Darexsh/IoT_Wetterstation/3D-Case/Frame.stl

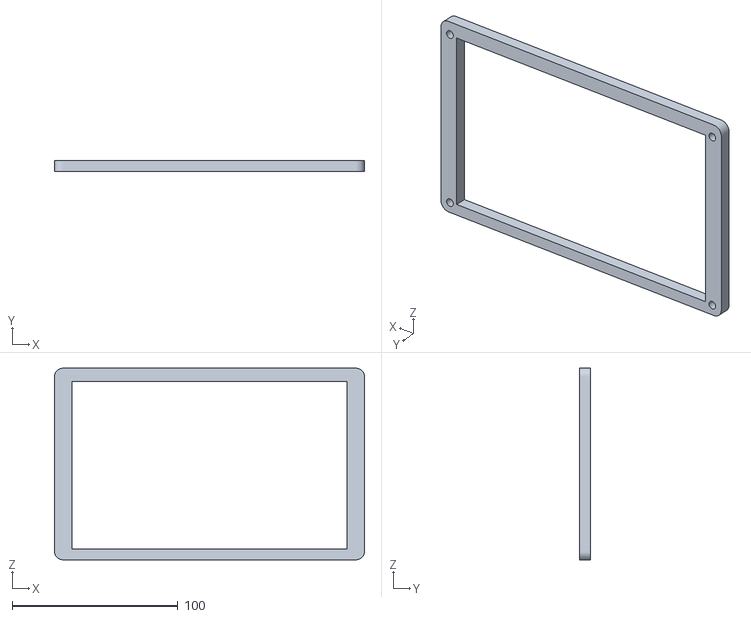
[picture p4: CAD file, 2025-10-27]
3D-Case/Frame.stl
187.0 x 6.56 x 115.6
