Darexsh/IoT_Wetterstation/3D-Case/Wetterstation.3mf

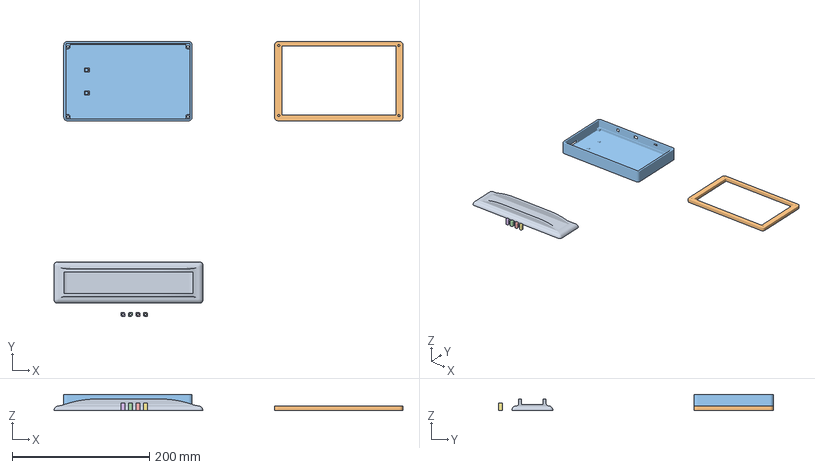
[picture p5: CAD file, 2025-10-22]
3D-Case/Wetterstation.3mf
508.4 x 400.6 x 23.7 mm
Stand.stl
Frame.stl
Case.stl
Spacer1.stl
Spacer2.stl
Spacer3.stl
Spacer4.stl
