Darexsh/IoT_Wetterstation/Hardware/Lib-3D-Files/SSD1963.step

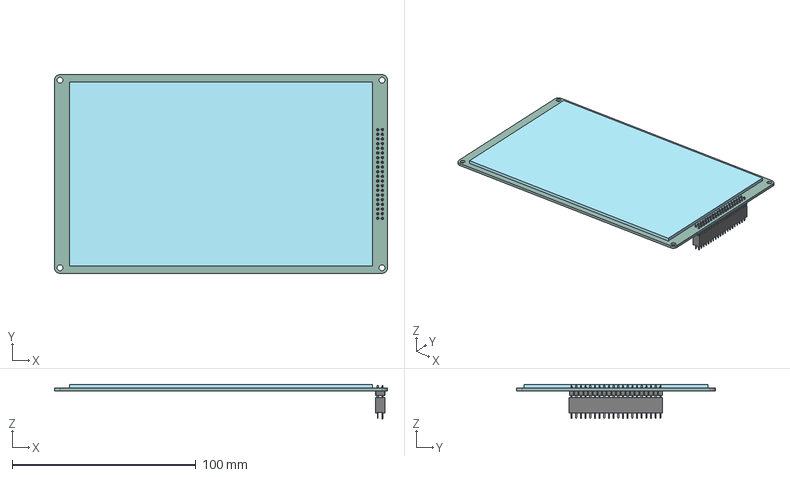
[picture p6: CAD file, 2025-09-12]
Hardware/Lib-3D-Files/SSD1963.step
181.0 x 108.0 x 18.7 mm
PinHeader_2x20_P254mm_Vertical
PinSocket_2x20_P2.54mm_Vertical
