Darexsh/IoT_Wetterstation/3D-Case/Spacer2.stl

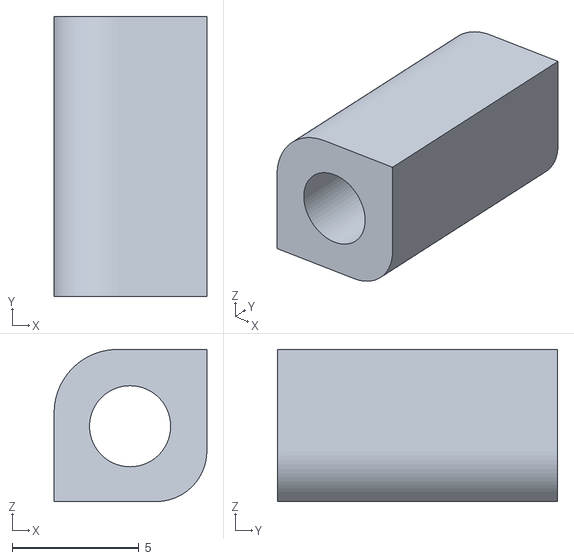
[picture p7: CAD file, 2025-10-21]
3D-Case/Spacer2.stl
6.03 x 11.1 x 6.00
