Darexsh/IoT_Wetterstation/Hardware/Lib-3D-Files/ESP32-S3-WROOM-1U-N8R8.stp

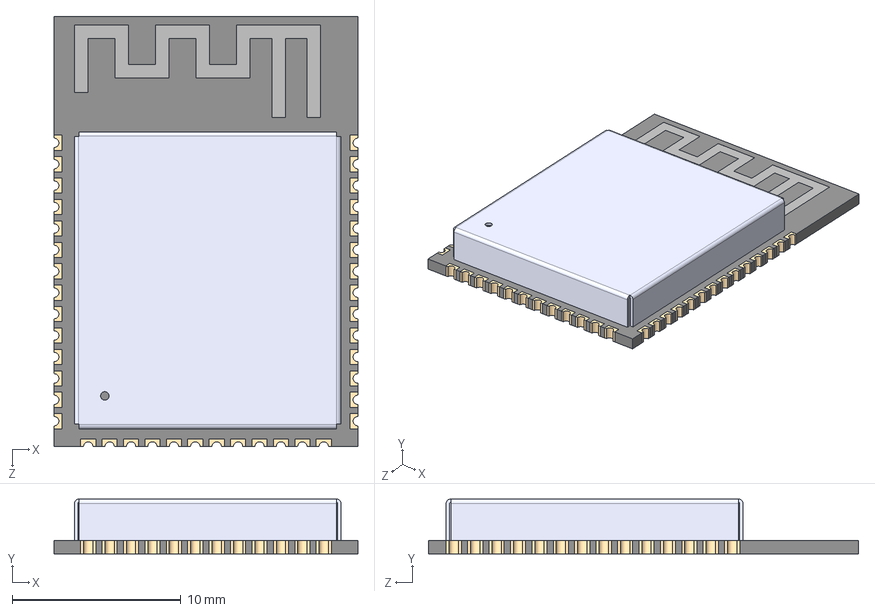
[picture p8: CAD file, 2025-09-12]
Hardware/Lib-3D-Files/ESP32-S3-WROOM-1U-N8R8.stp
18.0 x 3.25 x 25.5 mm
