Darexsh/IoT_Wetterstation/Hardware/Lib-3D-Files/KMR421NGLFS.step

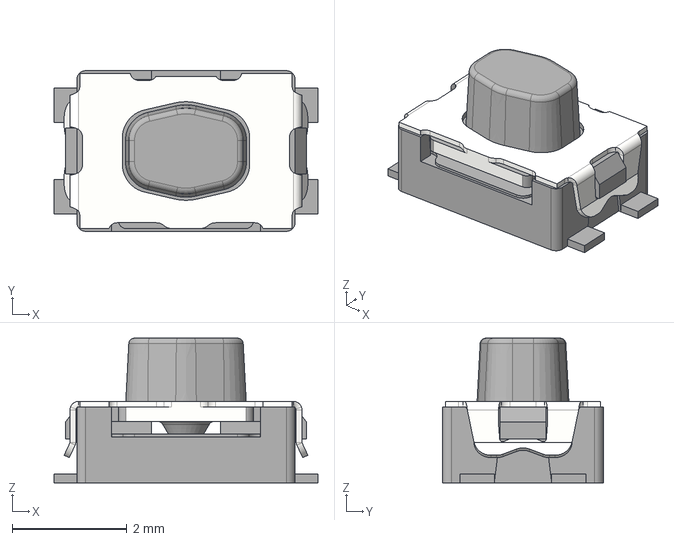
[picture p9: CAD file, 2025-09-12]
Hardware/Lib-3D-Files/KMR421NGLFS.step
4.60 x 2.80 x 2.52 mm
