Darexsh/IoT_Wetterstation/Hardware/Lib-3D-Files/USB-C.stp

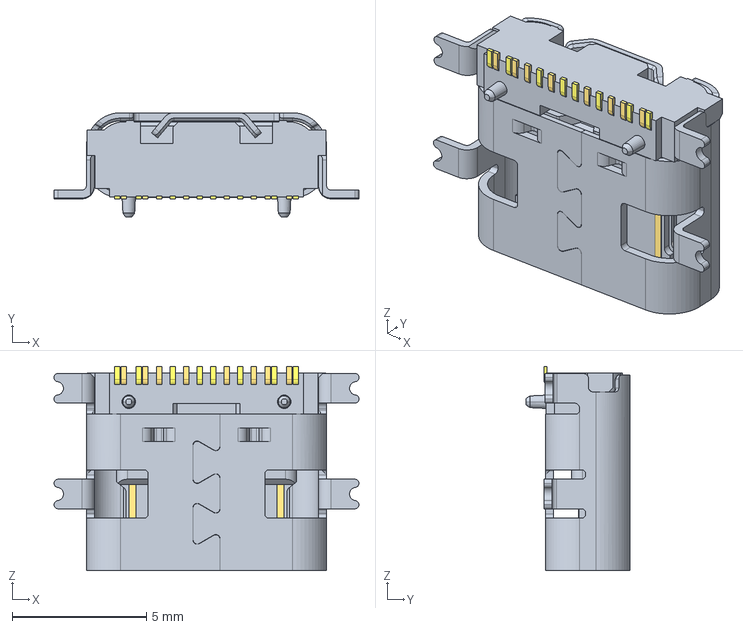
[picture p10: CAD file, 2025-09-12]
Hardware/Lib-3D-Files/USB-C.stp
11.3 x 3.89 x 7.60 mm
