Darexsh/IoT_Wetterstation/Hardware/Lib-3D-Files/JST-SH1.0-4P.stp

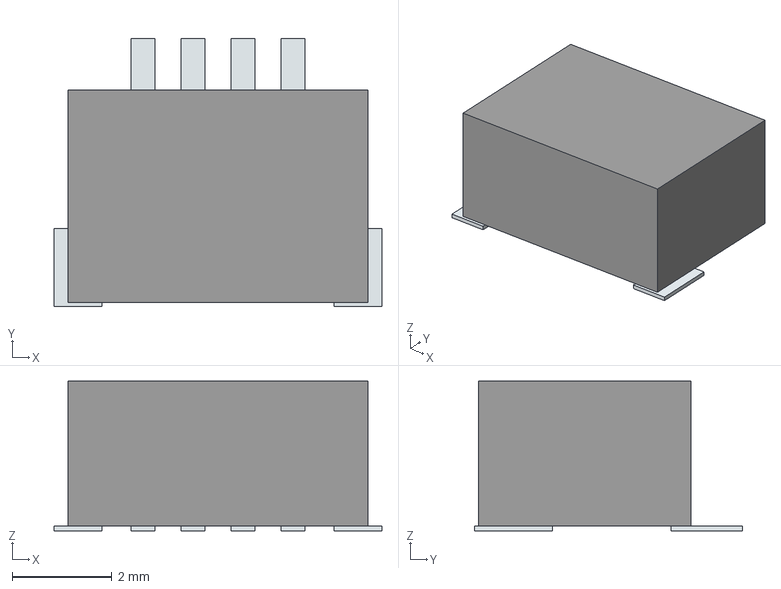
[picture p11: CAD file, 2025-09-12]
Hardware/Lib-3D-Files/JST-SH1.0-4P.stp
6.56 x 5.37 x 3.00 mm
Pins
