Darexsh/IoT_Wetterstation/3D-Case/Stand.stl

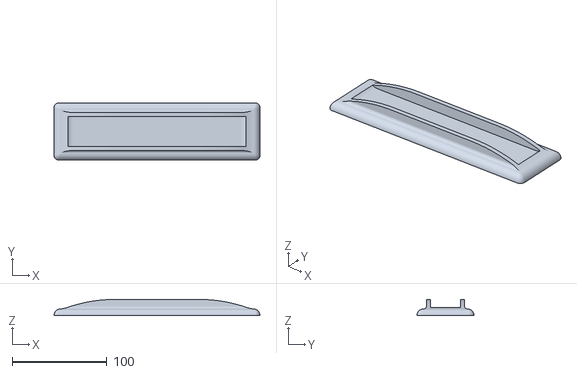
[picture p12: CAD file, 2025-10-21]
3D-Case/Stand.stl
217.0 x 60.2 x 17.0
