Darexsh/IoT_Wetterstation/Hardware/Lib-3D-Files/USB-C_PD.stp

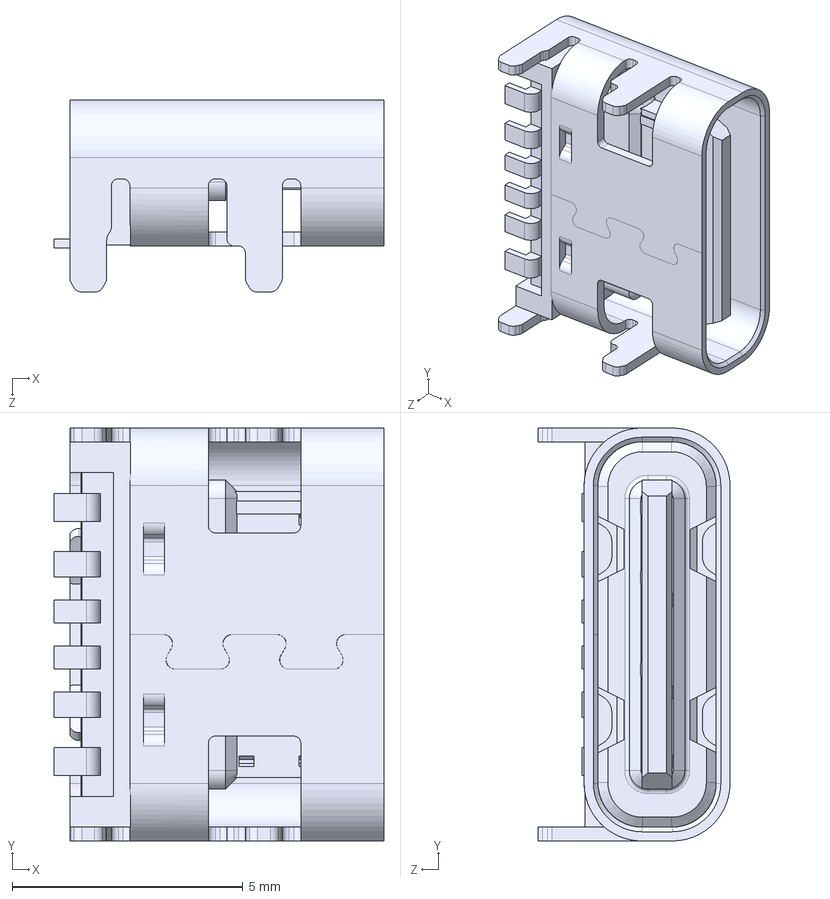
[picture p13: CAD file, 2025-09-12]
Hardware/Lib-3D-Files/USB-C_PD.stp
7.14 x 8.94 x 4.16 mm
