Darexsh/IoT_Wetterstation/3D-Case/Case.stl

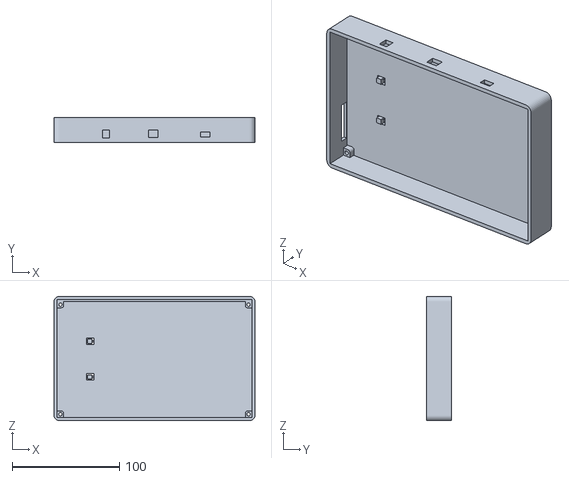
[picture p14: CAD file, 2025-10-21]
3D-Case/Case.stl
187.0 x 23.7 x 115.6
