Darexsh/IoT_Wetterstation/Hardware/Lib-3D-Files/VCNL4040M3OE.step

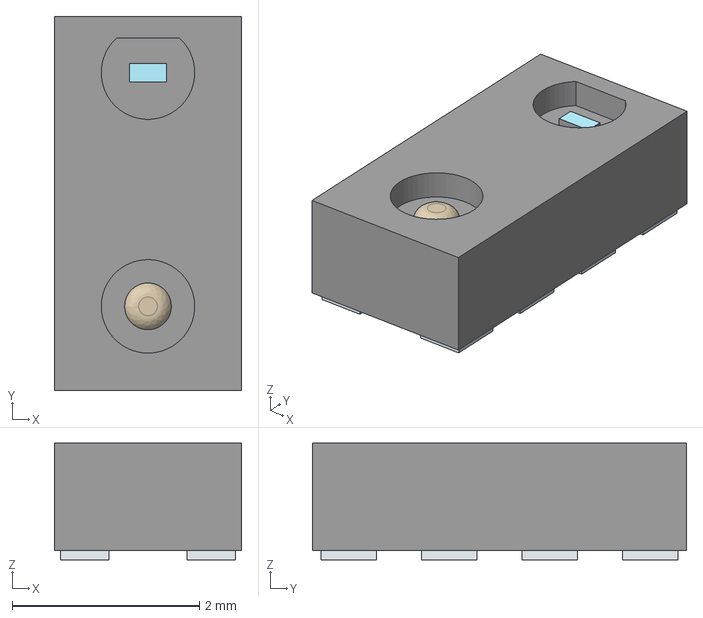
[picture p15: CAD file, 2025-09-12]
Hardware/Lib-3D-Files/VCNL4040M3OE.step
2.00 x 4.00 x 1.25 mm
Pins
