Darexsh/IoT_Wetterstation/Hardware/Lib-3D-Files/BME688.stp

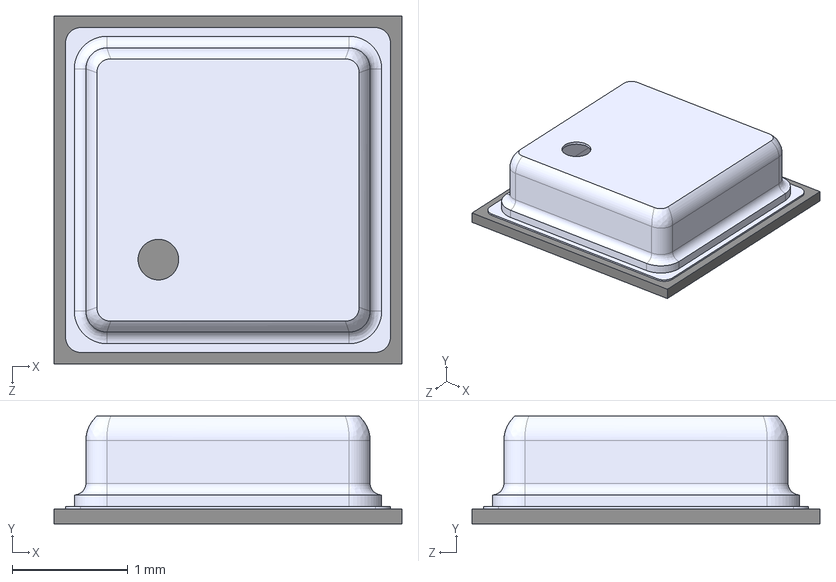
[picture p16: CAD file, 2025-09-12]
Hardware/Lib-3D-Files/BME688.stp
3.00 x 0.93 x 3.00 mm
