Darexsh/IoT_Wetterstation/(list of files, cad)

Other CAD files:
3D-Case/Spacer3.stl
3D-Case/Spacer4.stl
3D-Case/Spacer1.stl
