Darexsh/IoT_Wetterstation/Docs/iot_weatherstation_full_vcut_schematics.pdf

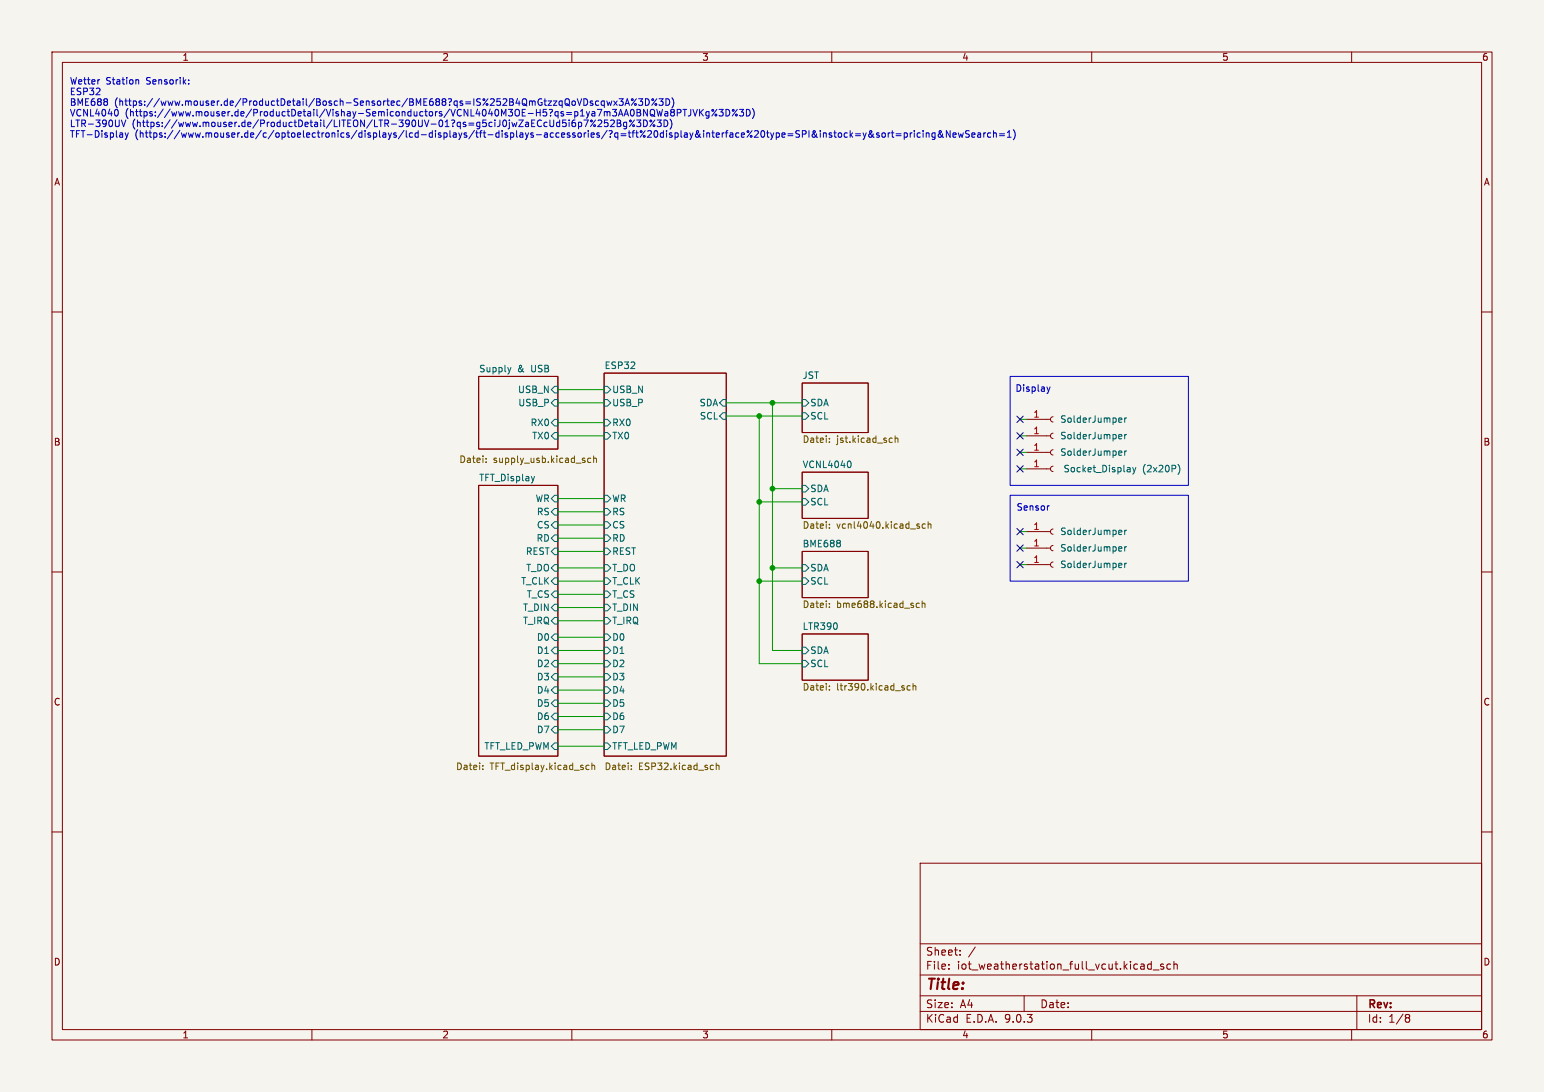
[picture p17: page 1]

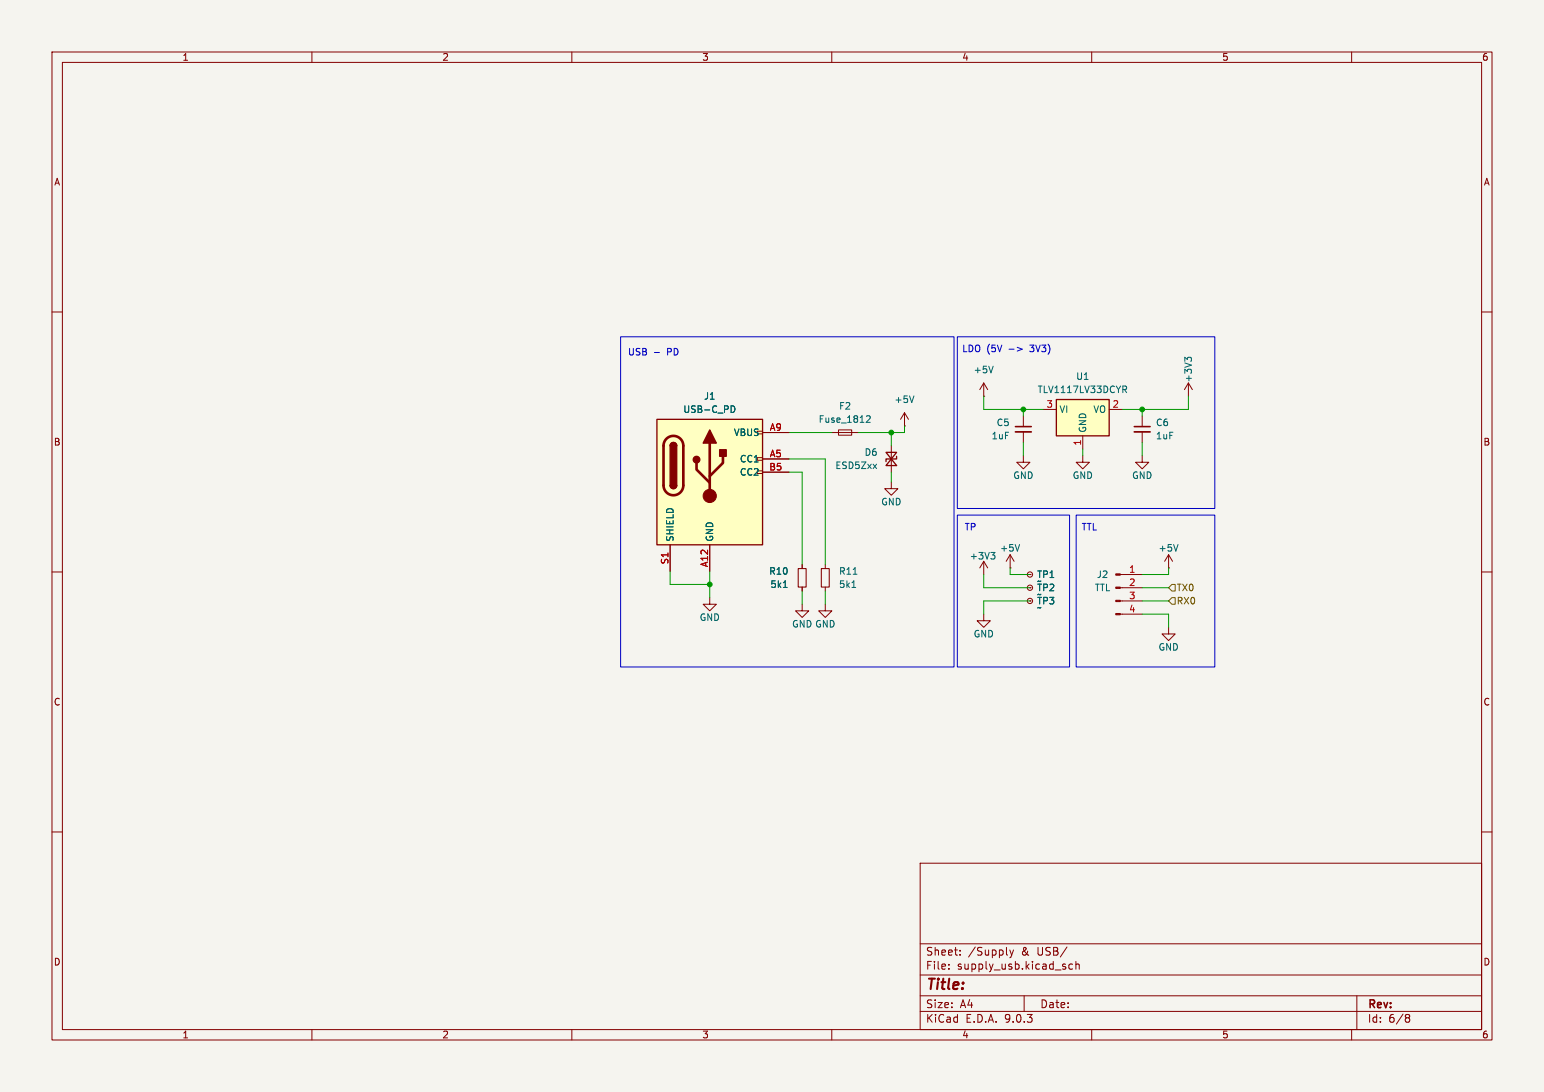
[picture p18: page 2]

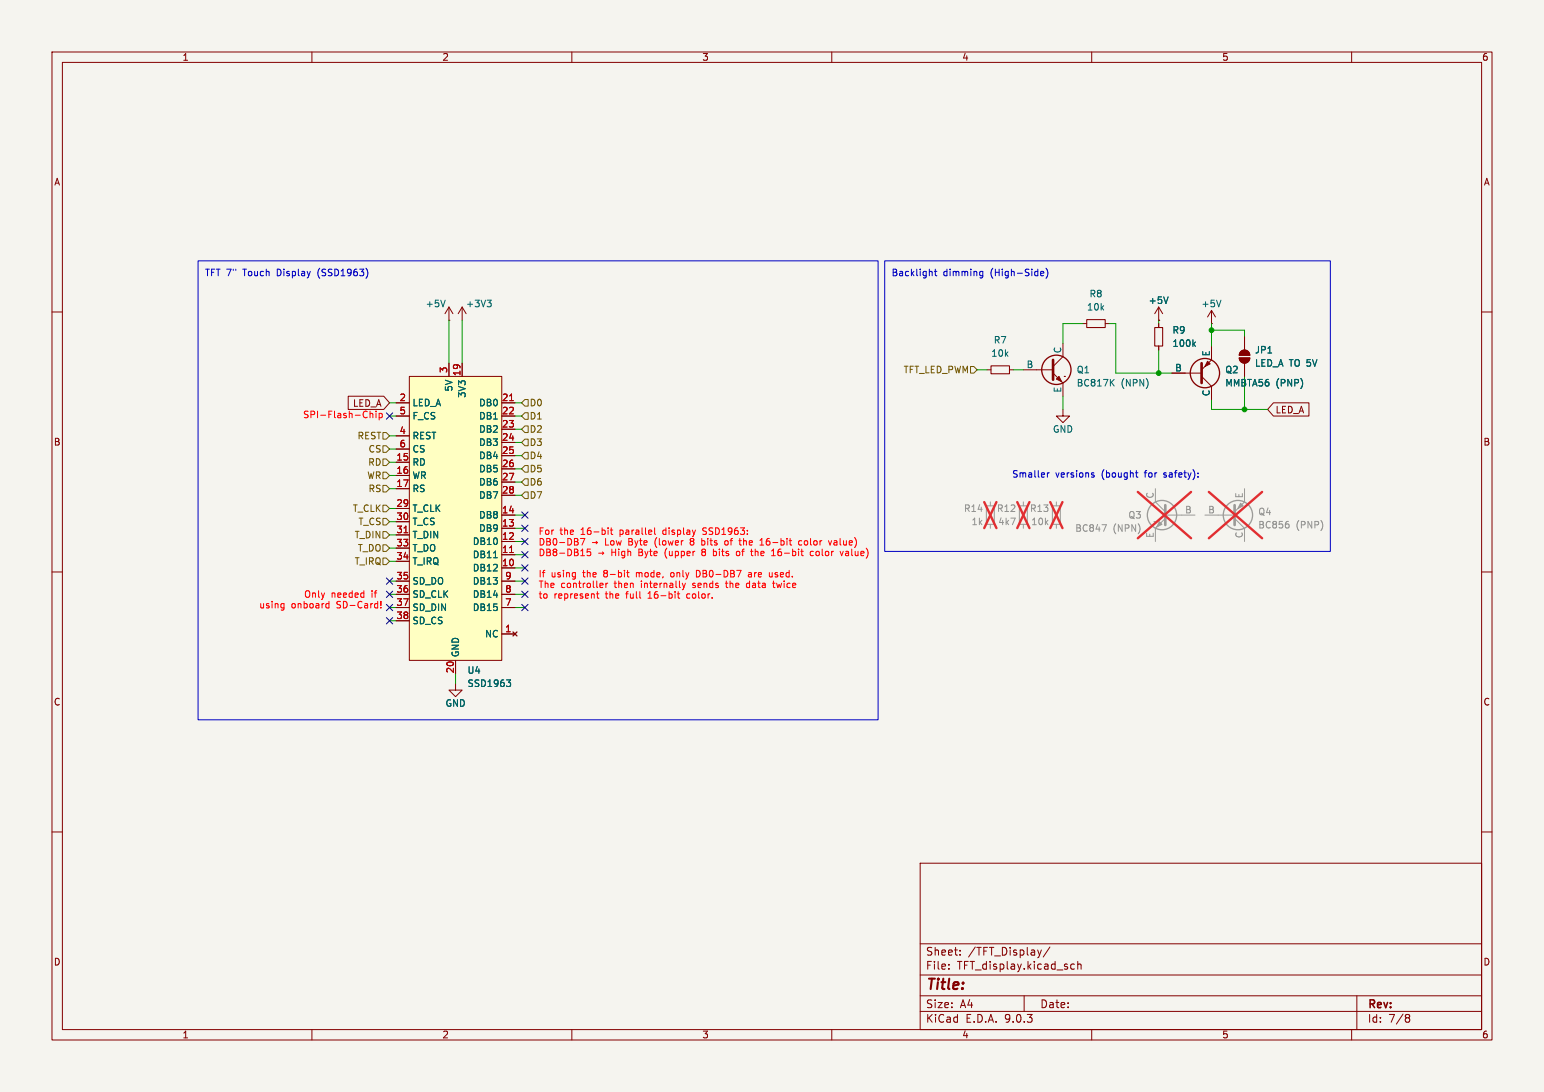
[picture p19: page 3]

Id: 7/8 Title: File: TFT_display.kicad_sch Sheet: /TFT_Display/ R14

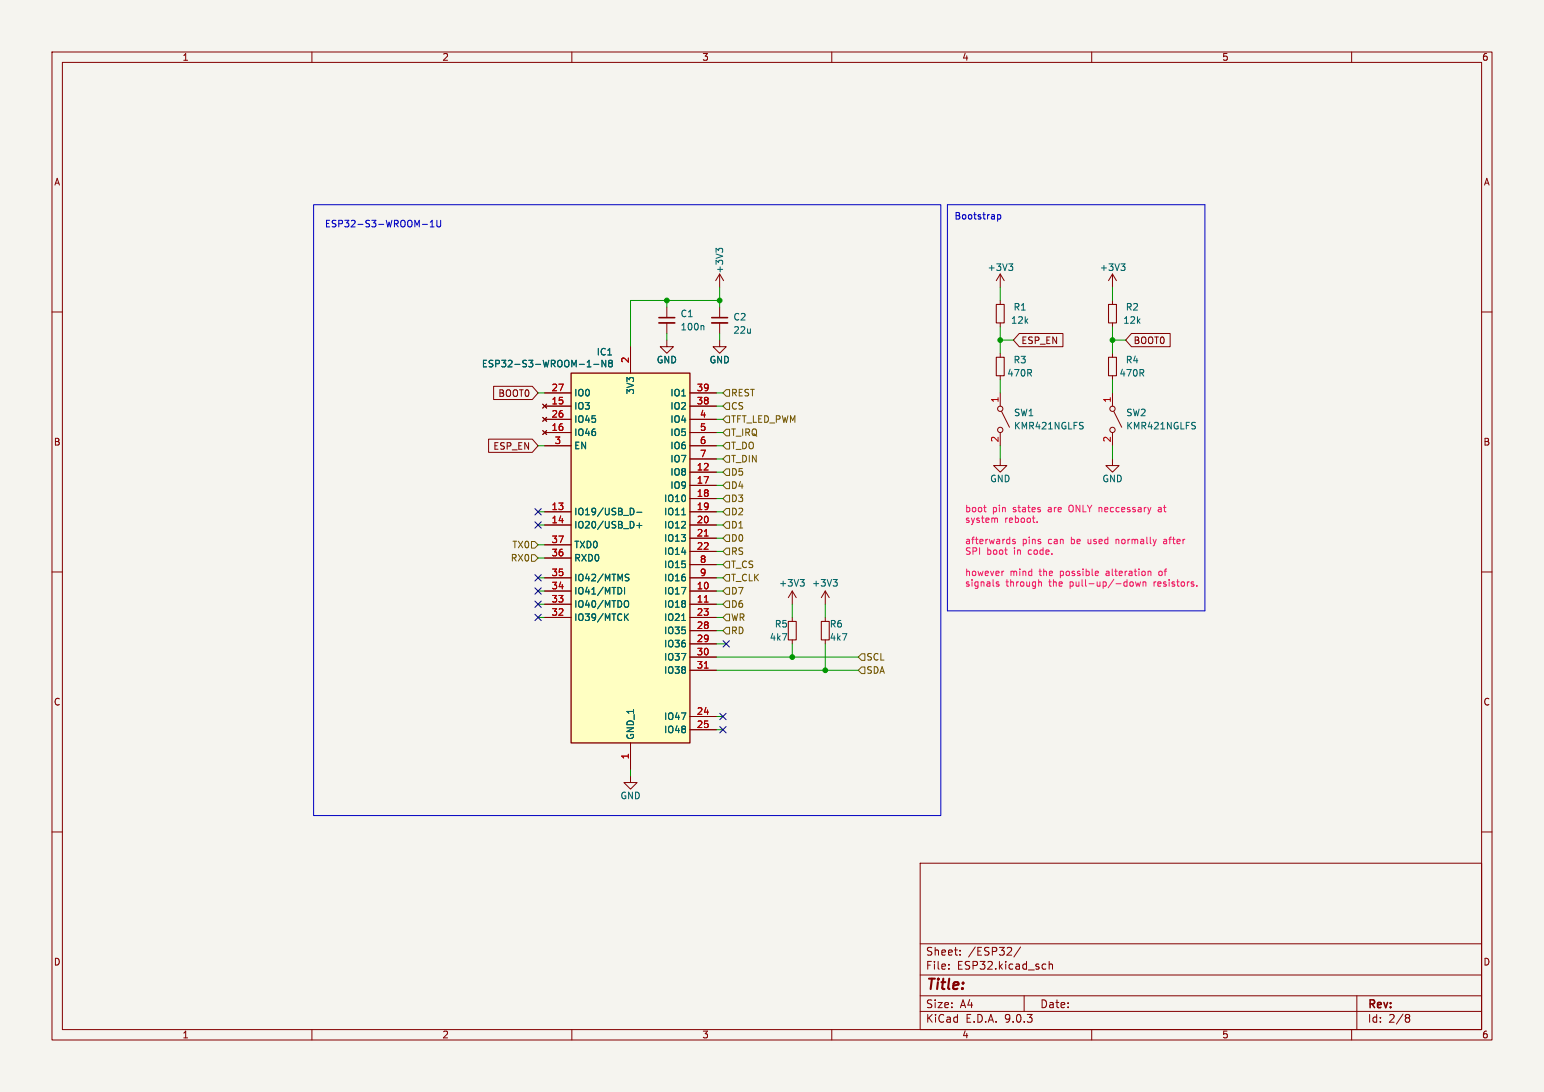
[picture p20: page 4]

Id: 2/8 Title: File: ESP32.kicad_sch Sheet: /ESP32/

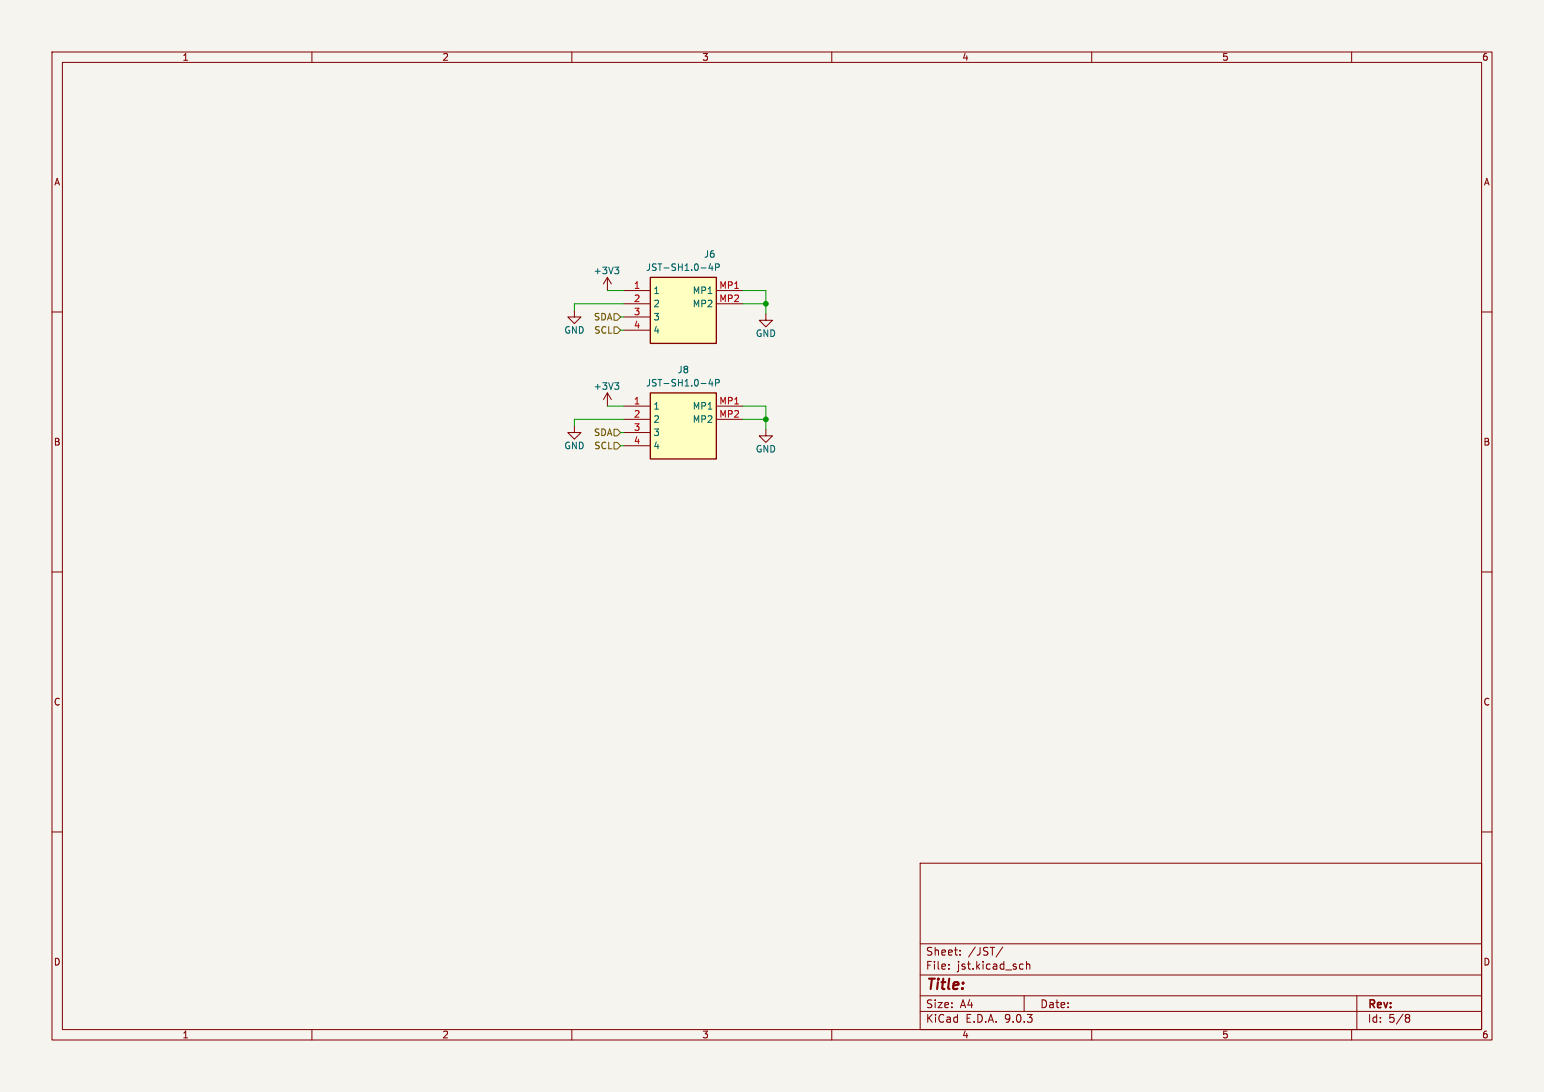
[picture p21: page 5]

Id: 5/8 Title: File: jst.kicad_sch Sheet: /JST/

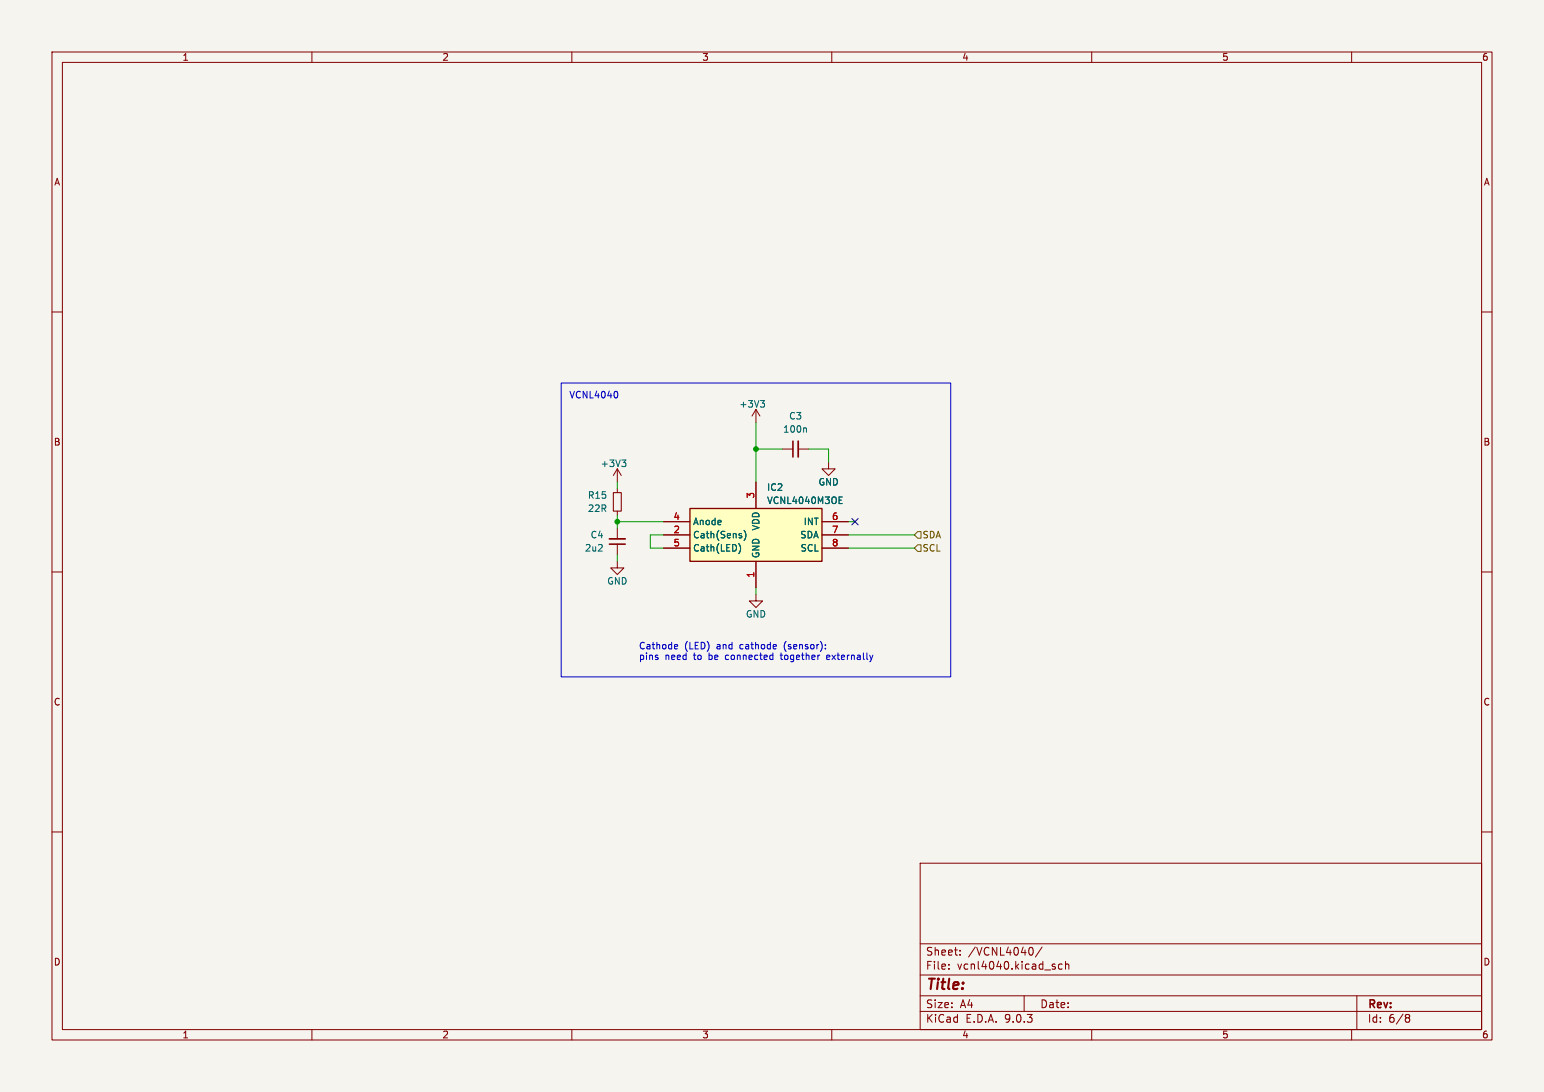
[picture p22: page 6]

Id: 6/8 Title: File: vcnl4040.kicad_sch Sheet: /VCNL4040/ GND

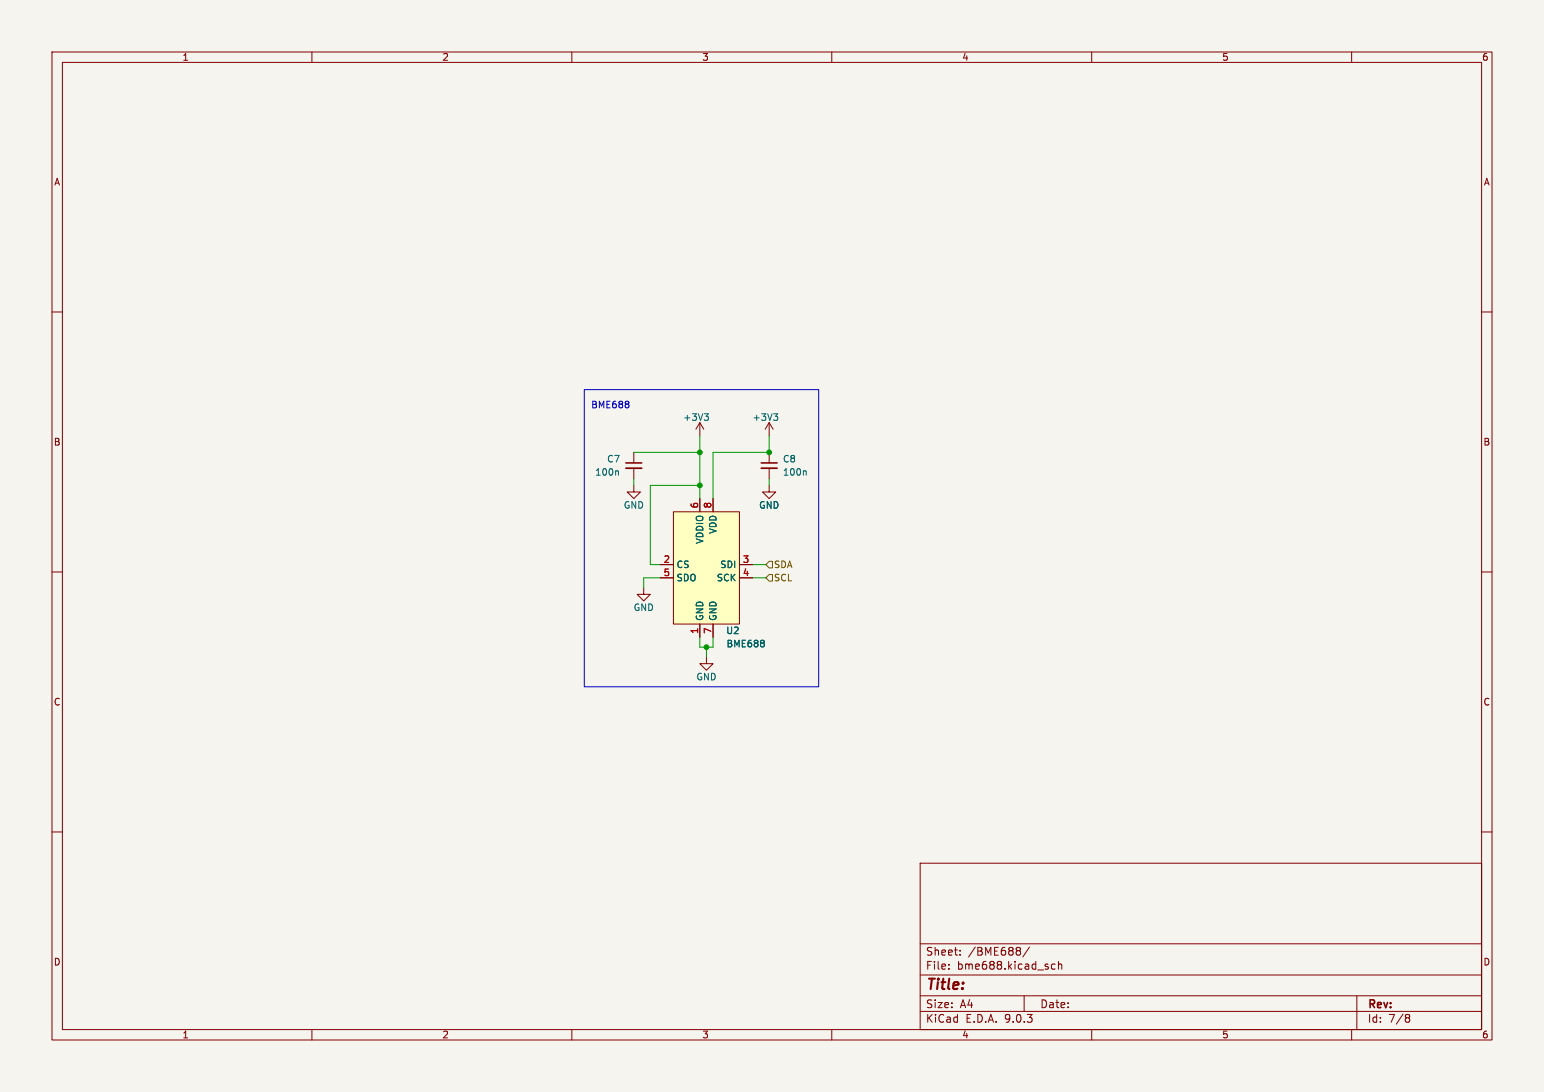
[picture p23: page 7]

Id: 7/8 Title: File: bme688.kicad_sch Sheet: /BME688/ GND

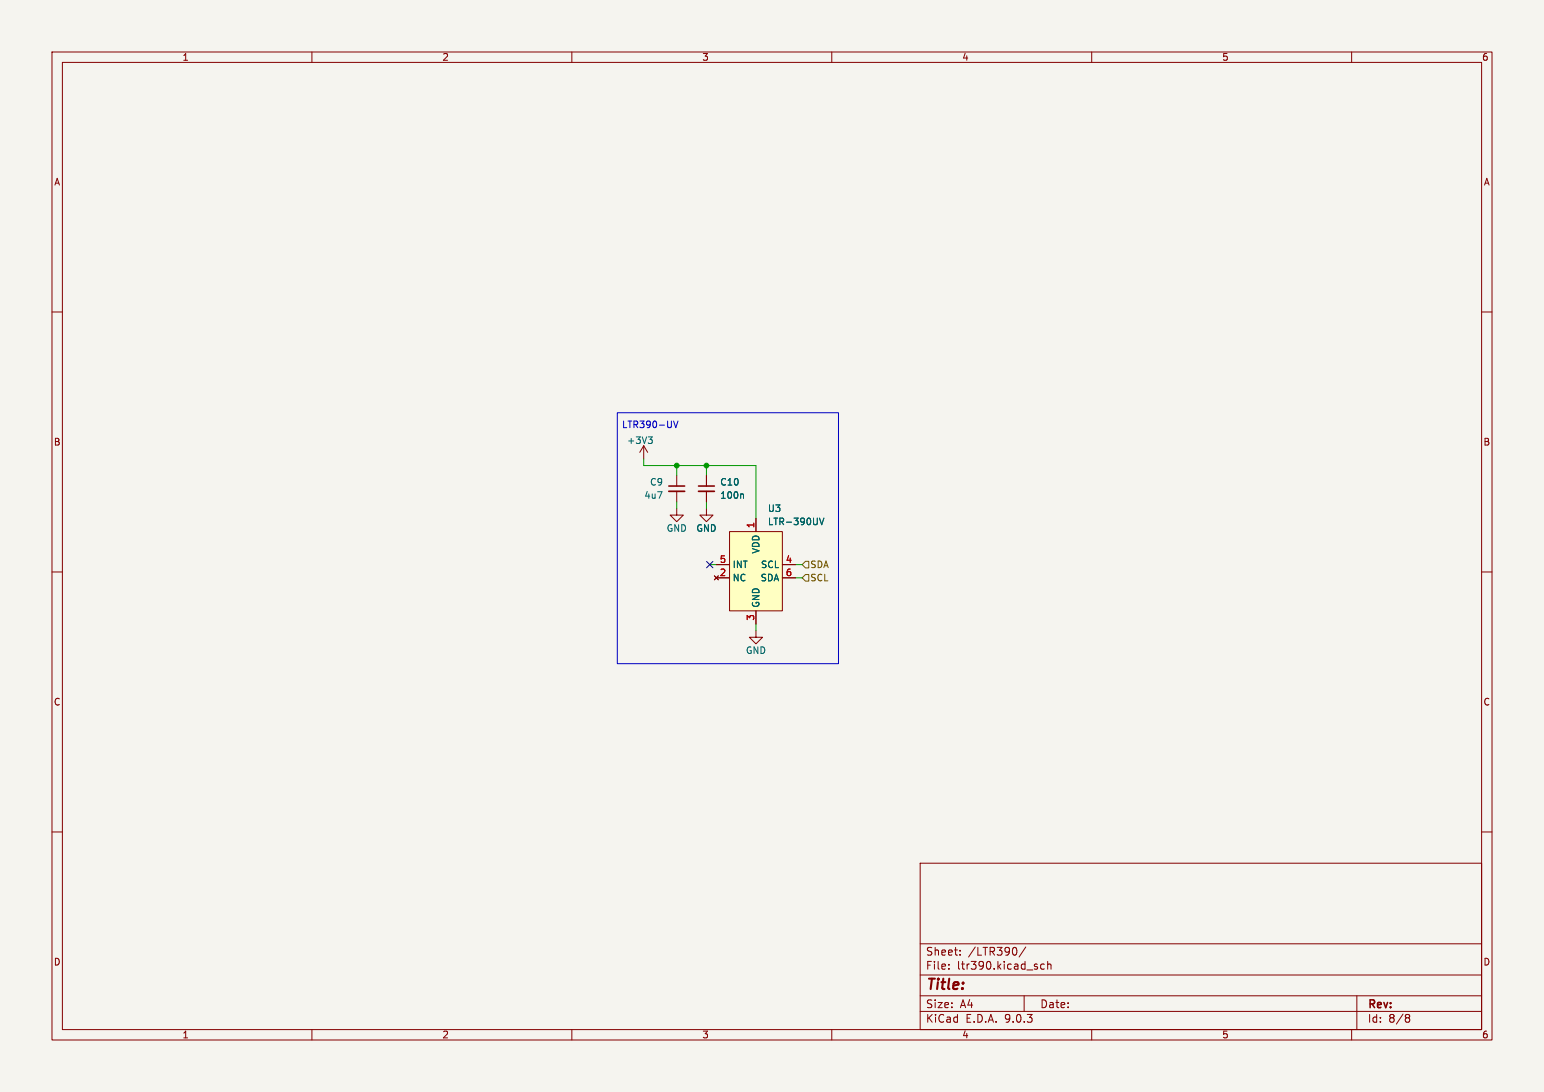
[picture p24: page 8]

Id: 8/8 Title: File: ltr390.kicad_sch Sheet: /LTR390/
