Darexsh/IoT_Wetterstation/Docs/iot_weatherstation_full_vcut_board_layers.pdf

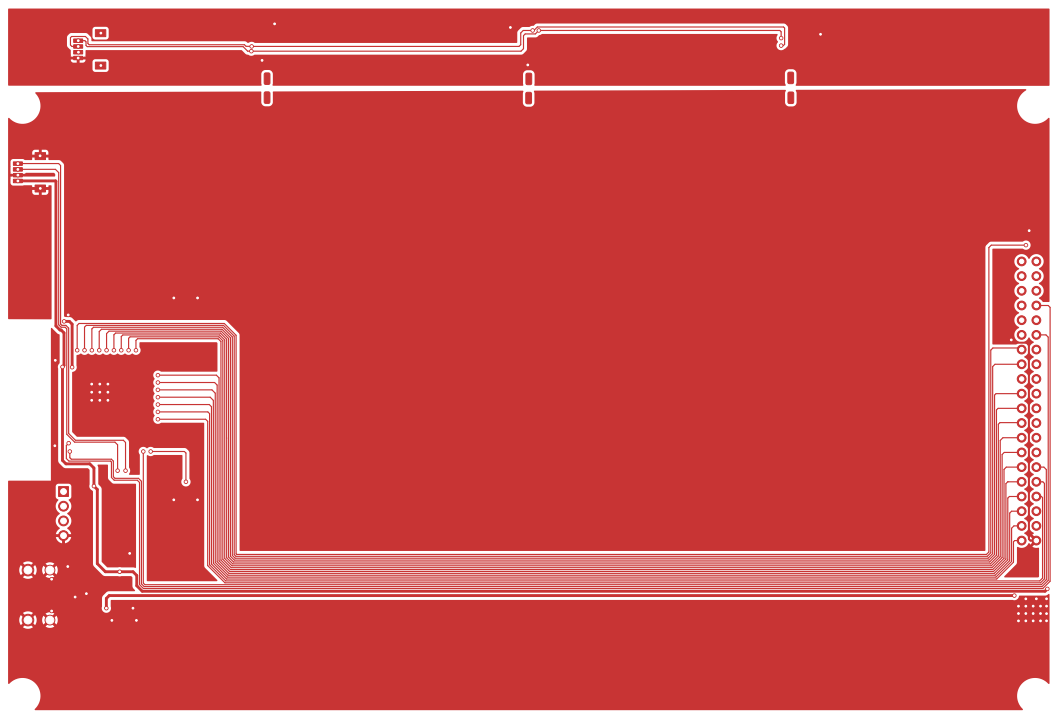
[picture p25: page 1]

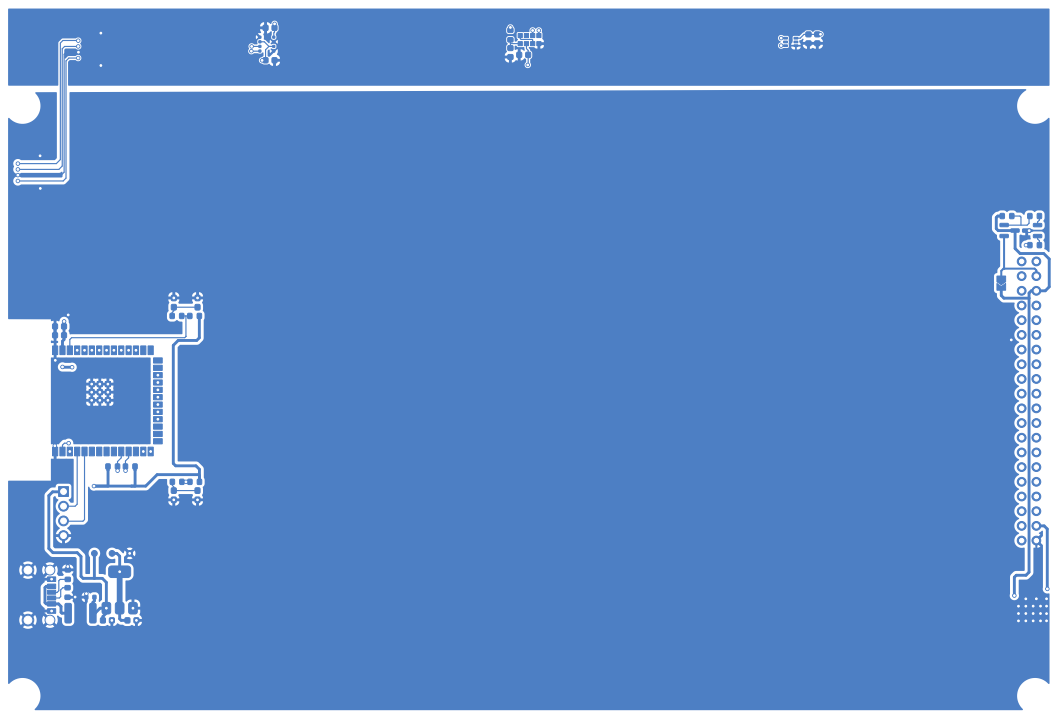
[picture p26: page 2]

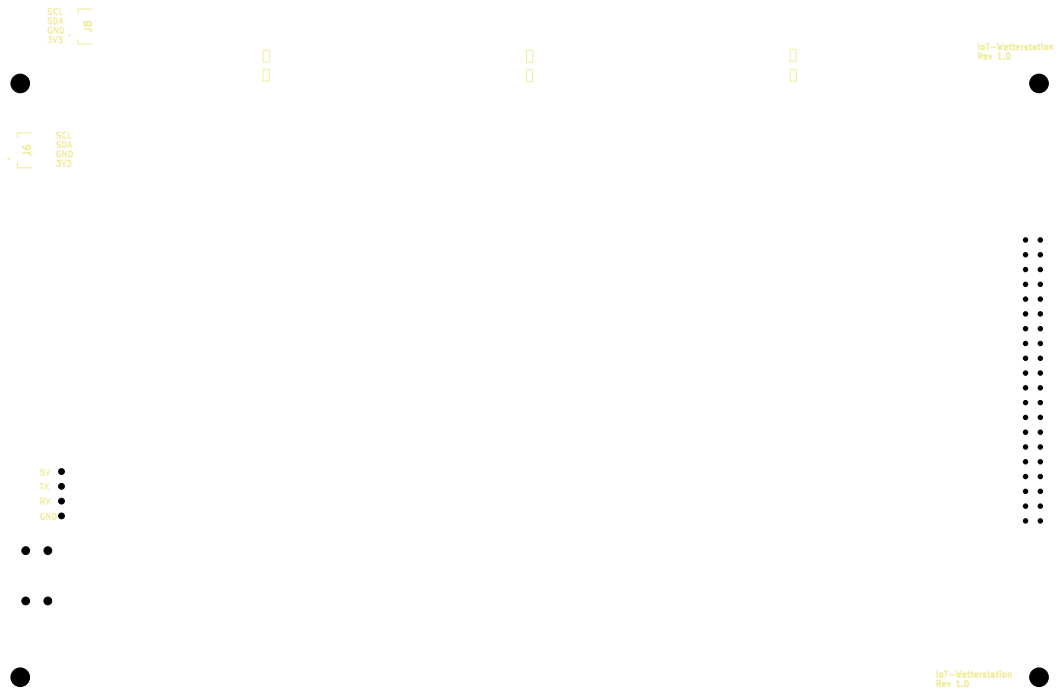
[picture p27: page 3]
5VGND

SCL SDA GND

IoT-Wetterstation Rev 1.0 RX

IoT-Wetterstation Rev 1.0

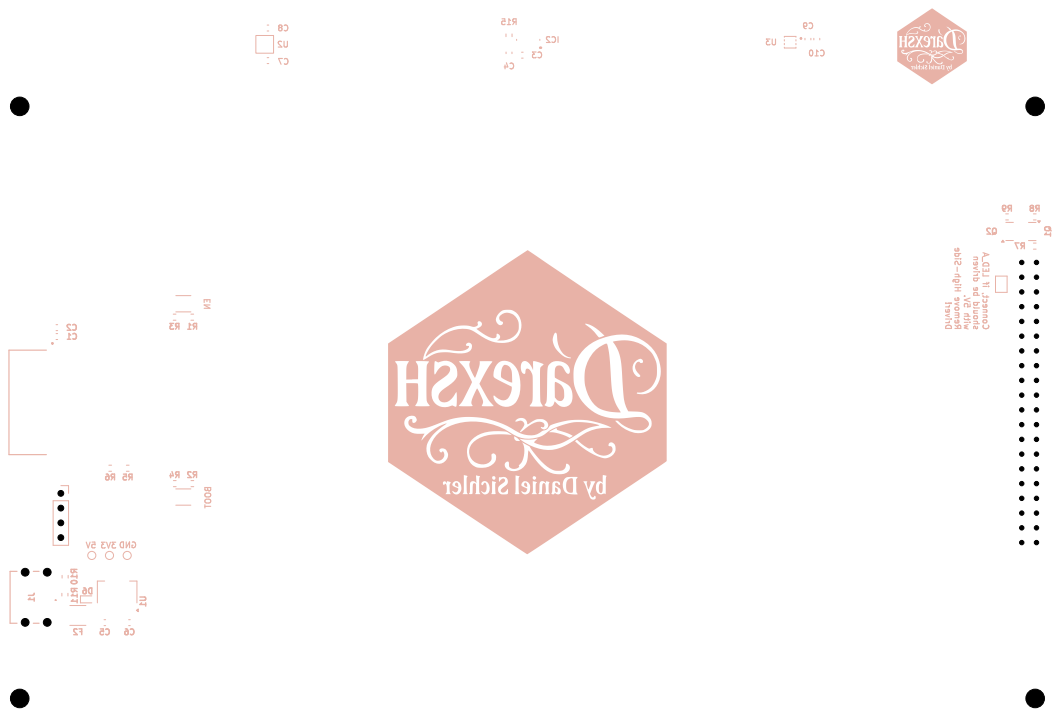
[picture p28: page 4]

5V EN BOOT Connect, if LED_A should be driven with 5V. Remove High-Side Driver!

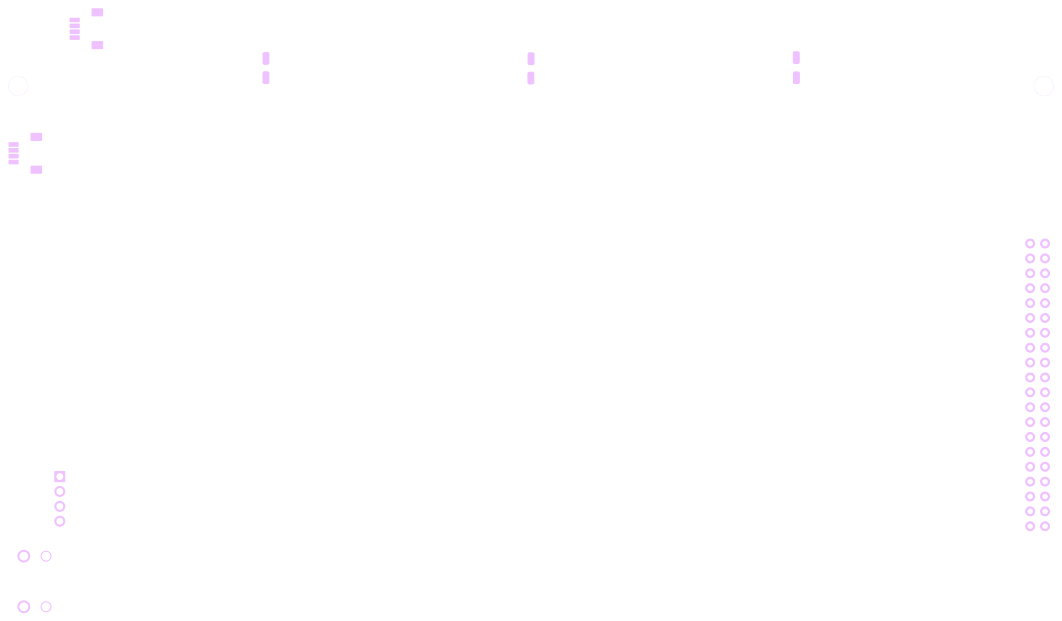
[picture p29: page 5]

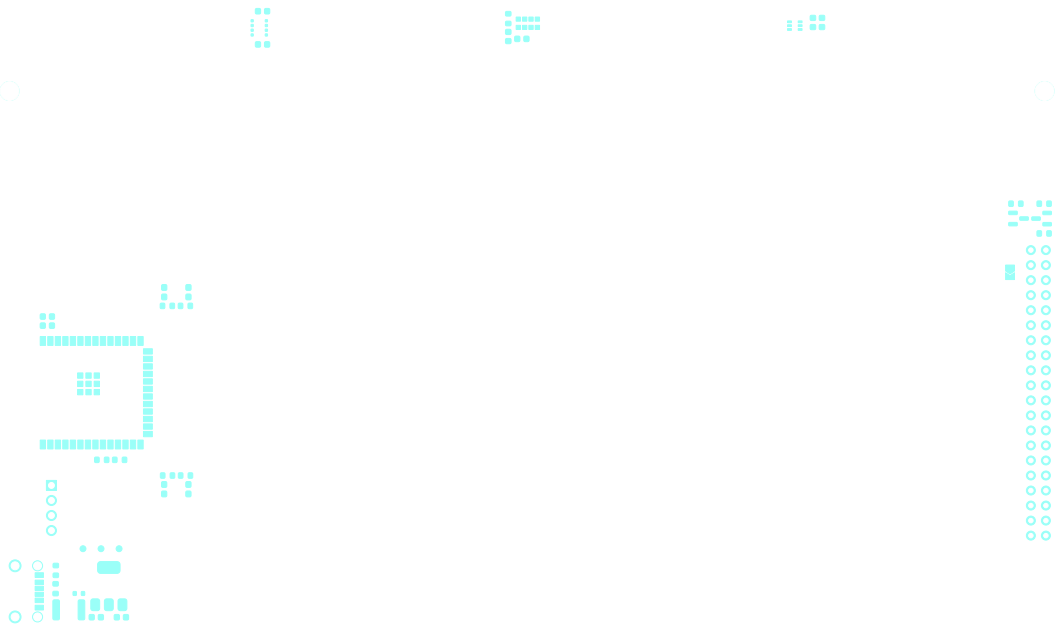
[picture p30: page 6]

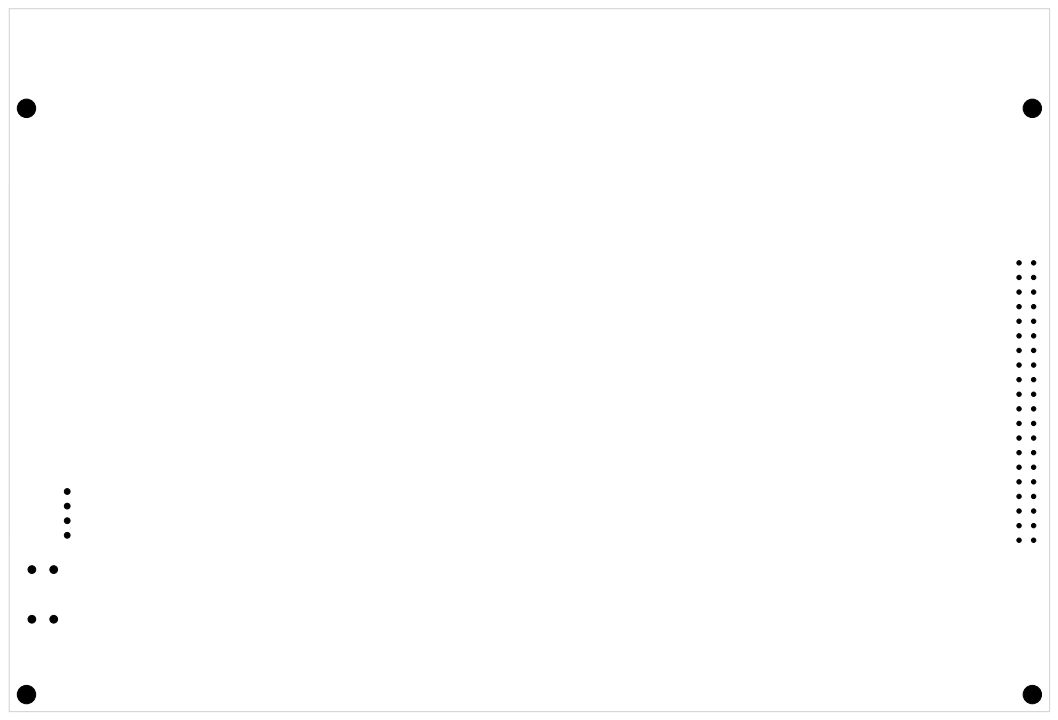
[picture p31: page 7]
