Darexsh/IoT_Wetterstation/Simulation/Backlight_simu.asc

Q1: npn; BC847A
Q2: pnp; BC857A
R1: res; 10k
R2: res; 10k
R3: res; 10k
R4: res; 100k
V1: voltage; PULSE(0 3.3 0 1n 1n 5n 10n)
V3: voltage; 5
Named nets: 0
.tran 1m
