Darexsh/IoT_Wetterstation/Hardware/iot_weatherstation_full_vcut.kicad_pcb

## KiCad design Hardware/iot_weatherstation_full_vcut.kicad_pcb (2025-10-22)

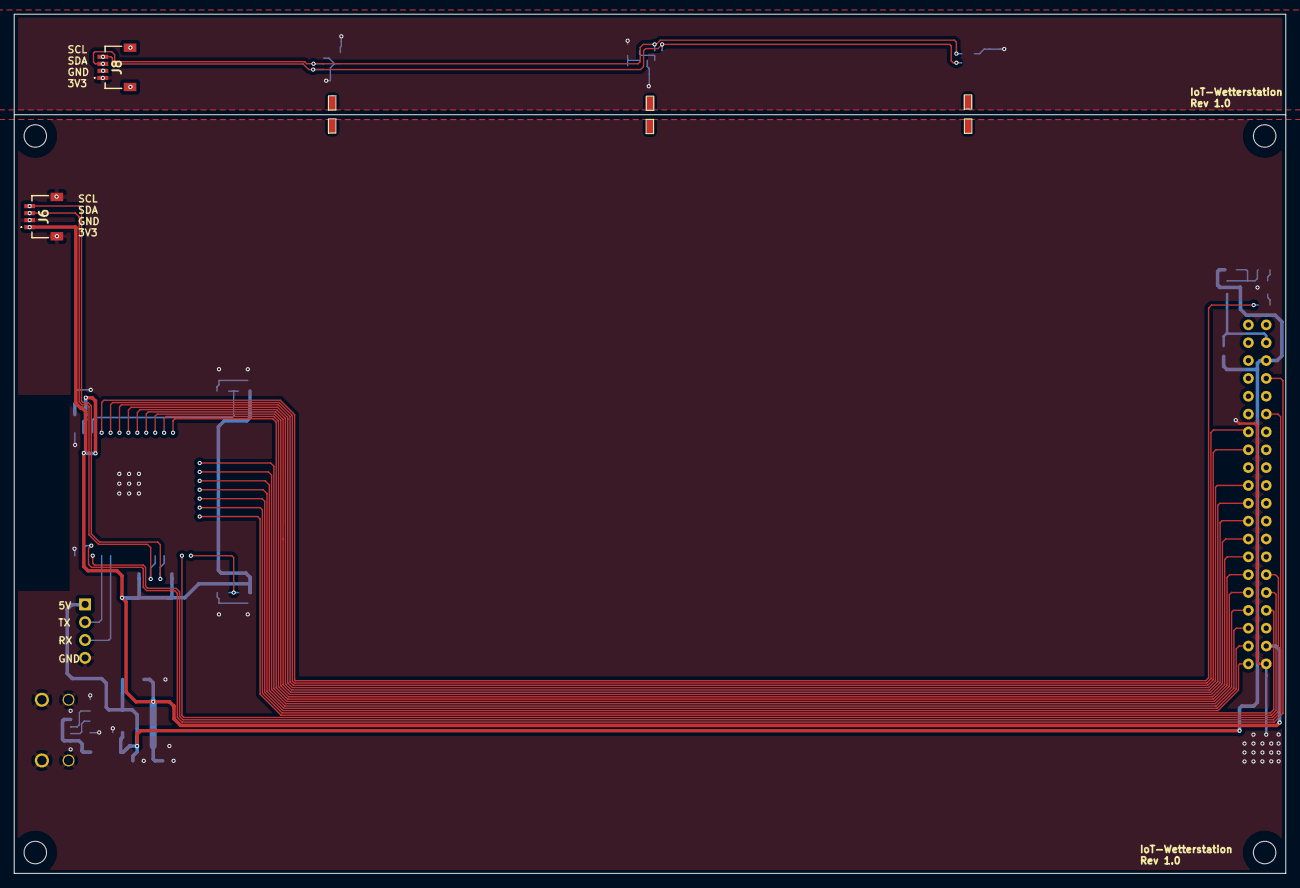
[picture p32: board iot_weatherstation_full_vcut.kicad_pcb from above]

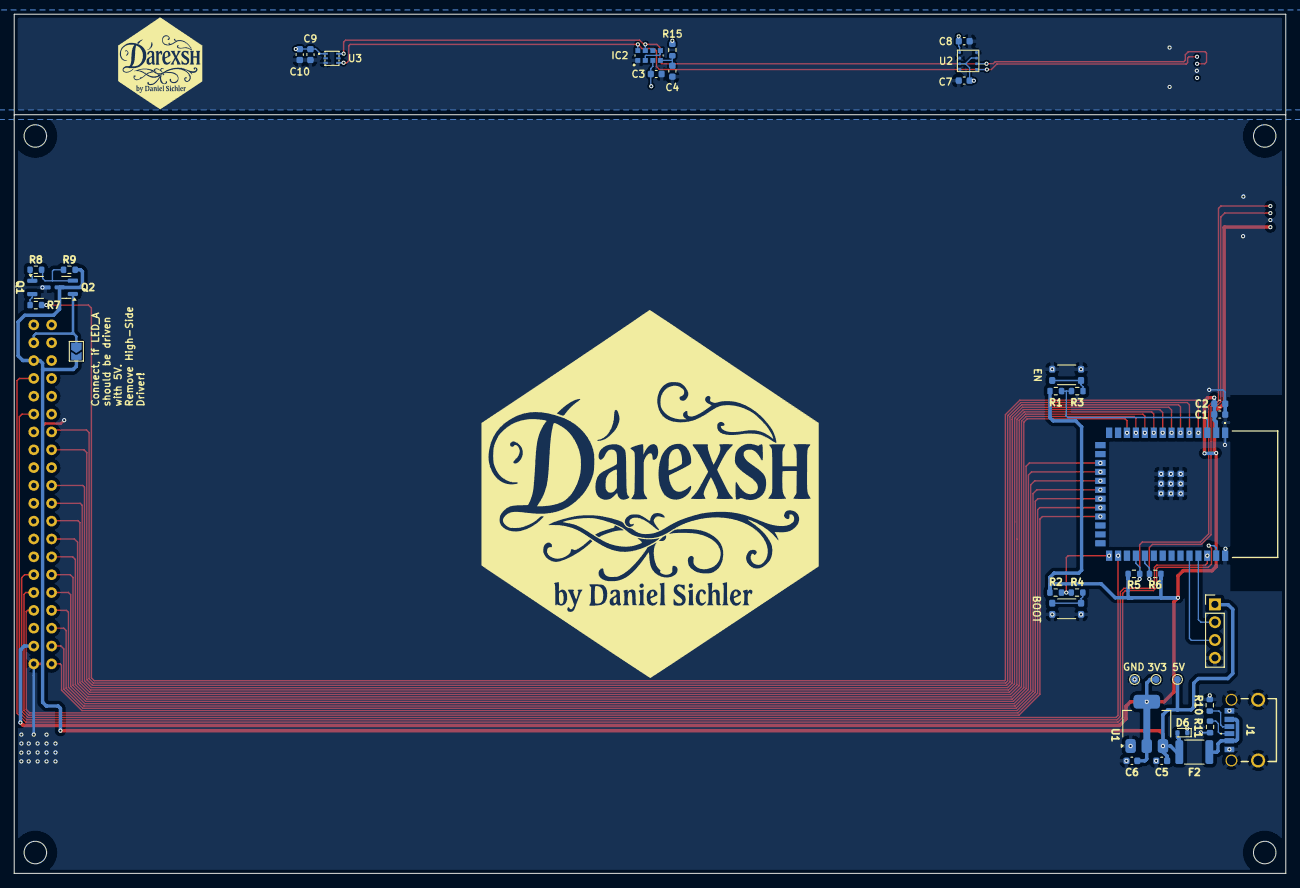
[picture p33: board iot_weatherstation_full_vcut.kicad_pcb from below]

Board: 2 copper layers, 181.0 x 122.3 mm, 48 parts (39 on the bottom side), 39 nets.

Parts:
C1, C3, C7, C8, C10: 100n; C_0603_1608Metric
C2: 22u; C_0603_1608Metric
C4: 2u2; C_0603_1608Metric
C5, C6: 1uF; C_0603_1608Metric
C9: 4u7; C_0603_1608Metric
D6: ESD5Zxx; D_SOD-523
F2: Fuse_1812; Fuse_1812_4532Metric
IC1: ESP32-S3-WROOM-1-N8; ESP32S3WROOM1N8R8
IC2: VCNL4040M3OE
J1: USB-C_PD
J2: TTL; PinHeader_1x04_P2.54mm_Vertical
J3, J4, J7, J9, J10, J11: SolderJumper; Solder_Jumper
J6, J8: JST-SH1.0-4P
JP1: LED_A TO 5V; SolderJumper-2_P1.3mm_Open_TrianglePad1.0x1.5mm
Q1: BC817K (NPN); SOT-23
Q2: MMBTA56 (PNP); SOT-23
R1, R2: 12k; R_0603_1608Metric
R3, R4: 470R; R_0603_1608Metric
R5, R6: 4k7; R_0603_1608Metric
R7, R8: 10k; R_0603_1608Metric
R9: 100k; R_0603_1608Metric
R10, R11: 5k1; R_0603_1608Metric
R15: 22R; R_0603_1608Metric
SW1, SW2: KMR421NGLFS
TP1, TP2, TP3: TestPoint_Pad_D1.0mm
U1: TLV1117LV33DCYR; SOT-223-3_TabPin2
U2: BME688
U3: LTR-390UV; LTR390UV01
U4: SSD1963

Connections:
+3V3: C1.1, C2.1, C3.1, C6.1, C7.1, C8.1, C9.1, C10.1, IC1.2 (3V3), IC2.3 (VDD), J6.1, J8.1, R1.2, R2.2, R5.1, R6.1, R15.2, TP2.1, U1.2 (VO), U2.2 (CS), U2.6 (VDDIO), U2.8 (VDD), U3.1 (VDD), U4.19 (3V3)
+5V: C5.1, D6.2 (A2), F2.1, J2.1, JP1.2 (B), Q2.3 (E), R9.2, TP1.1, U1.3 (VI), U4.3 (5V)
/BME688/SCL: IC1.30 (IO37), IC2.8 (SCL), J6.4, J8.4, R5.2, U2.4 (SCK), U3.4 (SCL)
/BME688/SDA: IC1.31 (IO38), IC2.7 (SDA), J6.3, J8.3, R6.2, U2.3 (SDI), U3.6 (SDA)
/ESP32/CS: IC1.38 (IO2), U4.6 (CS)
/ESP32/D0: IC1.21 (IO13), U4.21 (DB0)
/ESP32/D1: IC1.20 (IO12), U4.22 (DB1)
/ESP32/D2: IC1.19 (IO11), U4.23 (DB2)
/ESP32/D3: IC1.18 (IO10), U4.24 (DB3)
/ESP32/D4: IC1.17 (IO9), U4.25 (DB4)
/ESP32/D5: IC1.12 (IO8), U4.26 (DB5)
/ESP32/D6: IC1.11 (IO18), U4.27 (DB6)
/ESP32/D7: IC1.10 (IO17), U4.28 (DB7)
/ESP32/RD: IC1.28 (IO35), U4.15 (RD)
/ESP32/REST: IC1.39 (IO1), U4.4 (REST)
/ESP32/RS: IC1.22 (IO14), U4.17 (RS)
/ESP32/RX0: IC1.36 (RXD0), J2.3
/ESP32/TFT_LED_PWM: IC1.4 (IO4), R7.1
/ESP32/TX0: IC1.37 (TXD0), J2.2
/ESP32/T_CLK: IC1.9 (IO16), U4.29 (T_CLK)
/ESP32/T_CS: IC1.8 (IO15), U4.30 (T_CS)
/ESP32/T_DIN: IC1.7 (IO7), U4.31 (T_DIN)
/ESP32/T_DO: IC1.6 (IO6), U4.33 (T_DO)
/ESP32/T_IRQ: IC1.5 (IO5), U4.34 (T_IRQ)
/ESP32/WR: IC1.23 (IO21), U4.16 (WR)
BOOT0: IC1.27 (IO0), R2.1, R4.2
ESP_EN: IC1.3 (EN), R1.1, R3.2
GND: C1.2, C2.2, C3.2, C4.1, C5.2, C6.2, C7.2, C8.2, C9.2, C10.2, D6.1 (A1), IC1.1 (GND_1), IC1.40 (GND_2), IC1.41 (GND_3), IC1.42 (GND_4), IC1.43 (GND_5), IC1.44 (GND_6), IC1.45 (GND_7), IC1.46 (GND_8), IC1.47 (GND_9), IC1.48 (GND_10), IC1.49 (GND_11), IC2.1 (GND), J1.A12 (GND), J1.B12 (GND), J1.S1 (SHIELD), J2.4, J6.2, J6.MP1, J6.MP2, J8.2, J8.MP1, J8.MP2, Q1.3 (E), R10.2, R11.2, SW1.2 (B), SW2.2 (B), TP3.1, U1.1 (GND), U2.1 (GND), U2.5 (SDO), U2.7 (GND), U3.3 (GND), U4.20 (GND)
LED_A: JP1.1 (A), Q2.1 (C), U4.2 (LED_A)
unnamed: F2.2, J1.A9 (VBUS), J1.B9 (VBUS)
unnamed: C4.2, IC2.4 (Anode), R15.1
unnamed: IC2.2 (Cath(Sens)), IC2.5 (Cath(LED))
unnamed: J1.A5 (CC1), R11.1
unnamed: J1.B5 (CC2), R10.1
unnamed: Q1.2 (B), R7.2
unnamed: Q1.1 (C), R8.1
unnamed: Q2.2 (B), R8.2, R9.1
unnamed: R3.1, SW1.1 (A)
unnamed: R4.1, SW2.1 (A)
