Darexsh/IoT_Wetterstation/(commit log)

2025-09-12 Added full weather station with v cut
    [BME688.stp, ESP32-S3-WROOM-1U-N8R8.stp, ESP32.kicad_sch, JST-SH1.0-4P.stp, KMR421NGLFS.step, LTR-390UV-01.stp, SSD1963.step, TFT_display.kicad_sch]
2025-09-12 Added Case
2025-09-12 Added 3D-Case
2025-09-12 Corrected gerber files
    [iot_weatherstation_full_vcut-B_Cu.gbr, iot_weatherstation_full_vcut-B_Mask.gbr, iot_weatherstation_full_vcut-B_Paste.gbr, iot_weatherstation_full_vcut-B_Silkscreen.gbr, iot_weatherstation_full_vcut-Edge_Cuts.gbr, iot_weatherstation_full_vcut-F_Cu.gbr, iot_weatherstation_full_vcut-F_Mask.gbr, iot_weatherstation_full_vcut-F_Paste.gbr]
2025-09-12 Changed gerber files
    [iot_weatherstation_full_vcut-B_Cu.gbr, iot_weatherstation_full_vcut-B_Mask.gbr, iot_weatherstation_full_vcut-B_Paste.gbr, iot_weatherstation_full_vcut-B_Silkscreen.gbr, iot_weatherstation_full_vcut-Edge_Cuts.gbr, iot_weatherstation_full_vcut-F_Cu.gbr, iot_weatherstation_full_vcut-F_Mask.gbr, iot_weatherstation_full_vcut-F_Paste.gbr]
2025-09-15 Update gerber files
    [iot_weatherstation_full_vcut-B_Cu.gbr, iot_weatherstation_full_vcut-B_Mask.gbr, iot_weatherstation_full_vcut-B_Paste.gbr, iot_weatherstation_full_vcut-B_Silkscreen.gbr, iot_weatherstation_full_vcut-Edge_Cuts.gbr, iot_weatherstation_full_vcut-F_Cu.gbr, iot_weatherstation_full_vcut-F_Mask.gbr, iot_weatherstation_full_vcut-F_Paste.gbr]
2025-10-21 Changed to press buttons from case
    [Case.stl, Frame.stl, Spacer1.stl, Spacer2.stl, Spacer3.stl, Spacer4.stl, Stand.stl]
2025-10-22 Swapped SCL und SDA for LTR (fucked up)
    [iot_weatherstation_full_vcut.kicad_pcb, ltr390.kicad_sch]
2025-10-22 Added 3mf for Bambu
    [Wetterstation.3mf]
2025-10-22 Bigger holes for inserts
    [Wetterstation.3mf]
2025-10-22 Tested with real sensors
2025-10-27 Changed hole size to fit inserts
    [Frame.stl]
